edaneault/Livre-RPIZ/cad/infos-vis-ecrous.txt

trou 3 mm diam
écrou 4.8 encore semi tight, 1.56mm d'épais

Plexi : 1.7 mm
