edaneault/Livre-RPIZ/images/FOND2.BMP

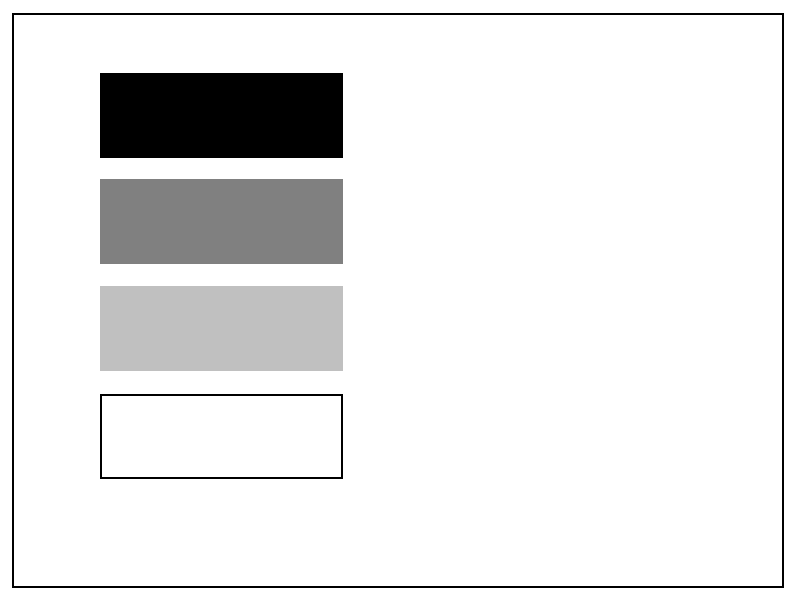
images/FOND2.BMP
