edaneault/Livre-RPIZ/images/FOND.BMP

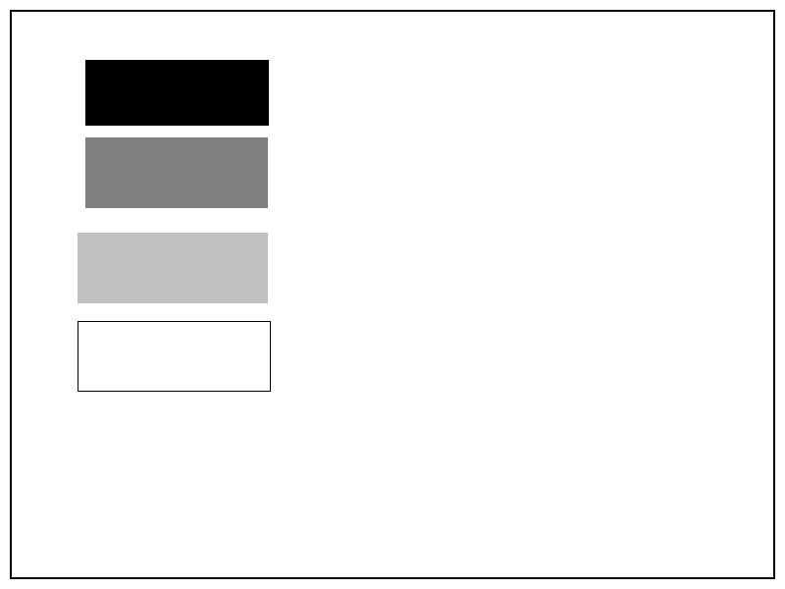
images/FOND.BMP
