edaneault/Livre-RPIZ/images/Maisonneuve.jpg

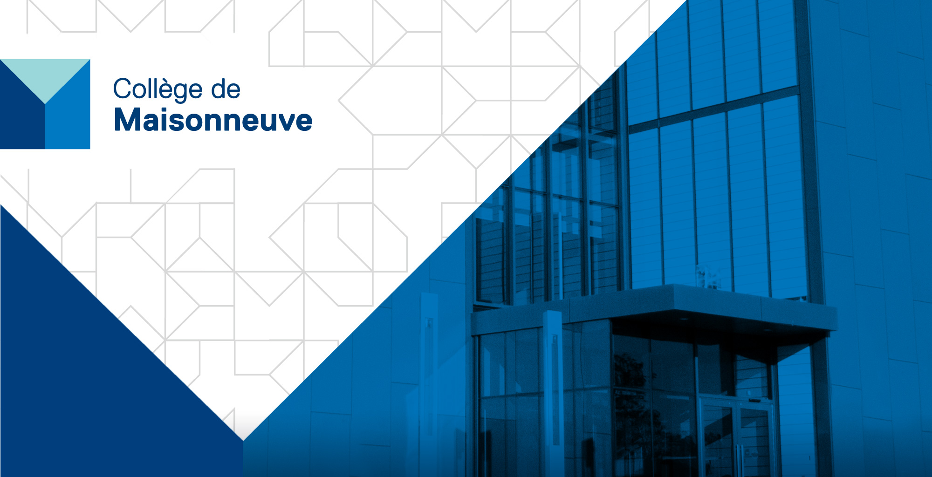
images/Maisonneuve.jpg
