edaneault/Livre-RPIZ/images/PIC4B.BMP

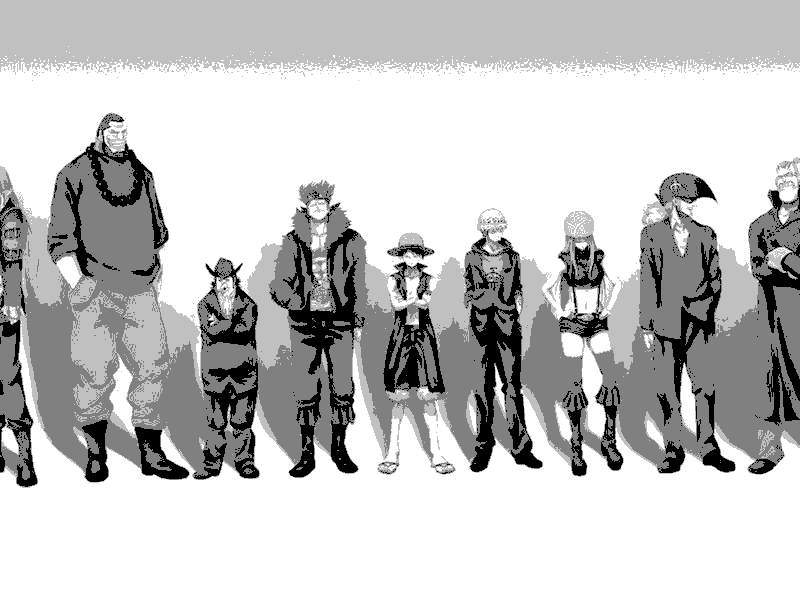
images/PIC4B.BMP
