edaneault/Livre-RPIZ/images/PIC22.BMP

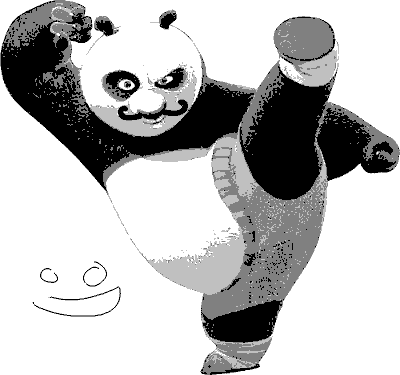
images/PIC22.BMP
