edaneault/Livre-RPIZ/images/selection/FIN23.BMP

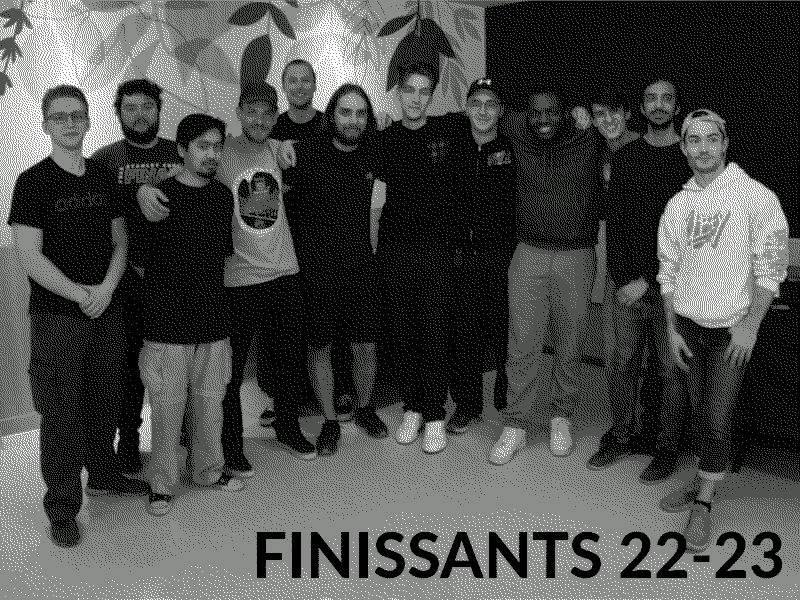
images/selection/FIN23.BMP
