edaneault/Livre-RPIZ/images/selection/KID.BMP

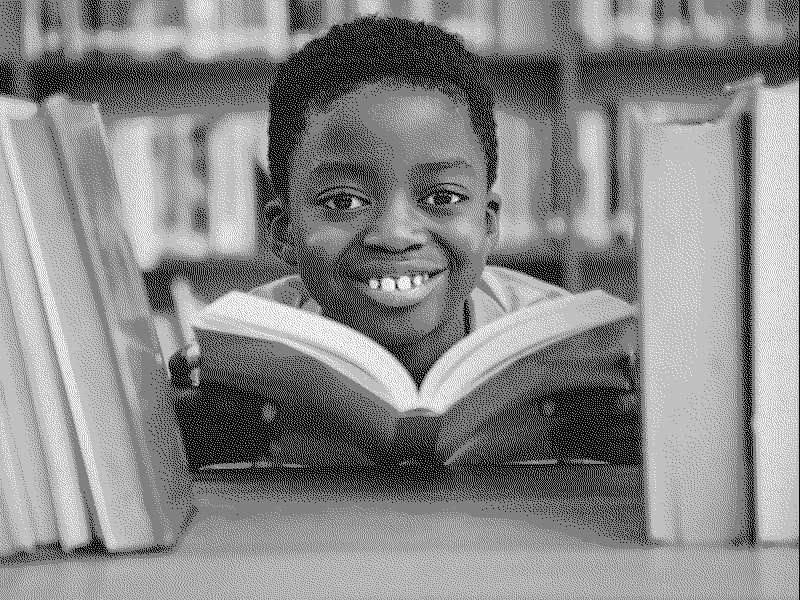
images/selection/KID.BMP
