edaneault/Livre-RPIZ/images/selection/L1984.BMP

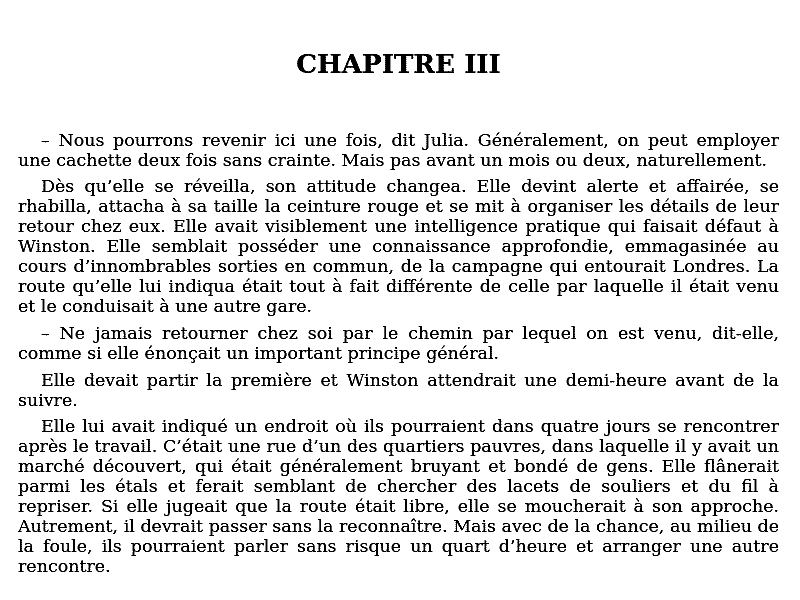
images/selection/L1984.BMP
