edaneault/Livre-RPIZ/images/selection/LABO.BMP

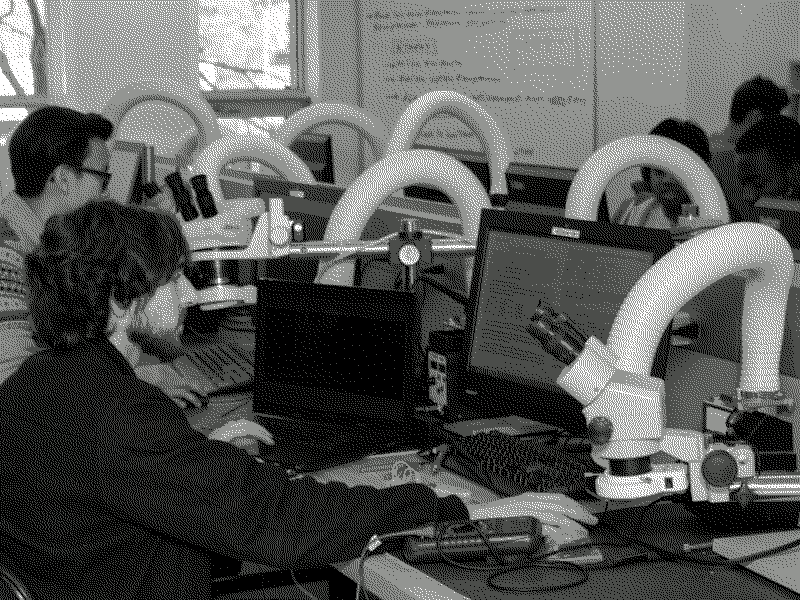
images/selection/LABO.BMP
