edaneault/Livre-RPIZ/images/selection/LIVRES.BMP

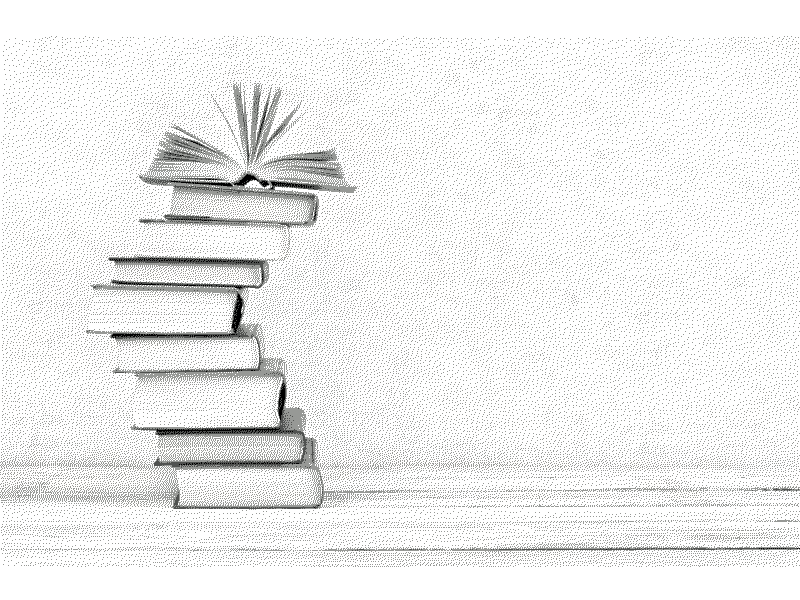
images/selection/LIVRES.BMP
