edaneault/Livre-RPIZ/images/selection/MAIS.BMP

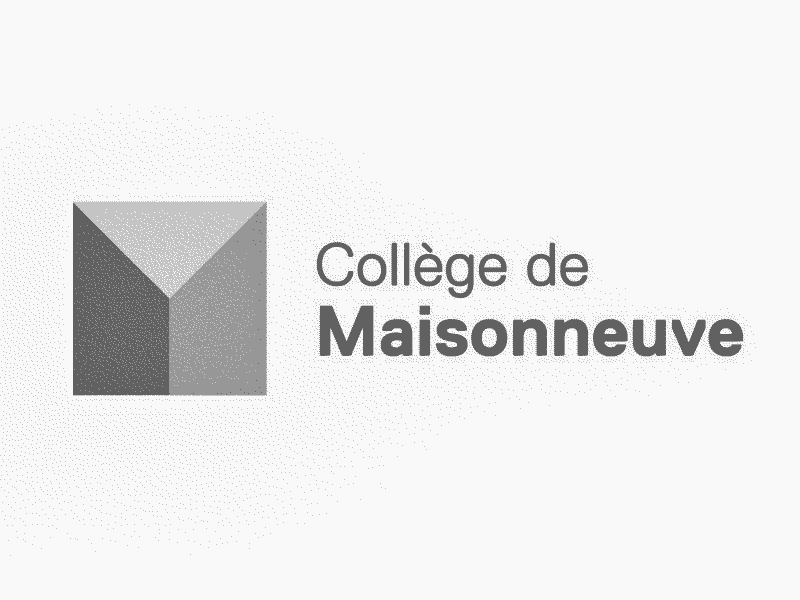
images/selection/MAIS.BMP
