edaneault/Livre-RPIZ/images/selection/MONTR.BMP

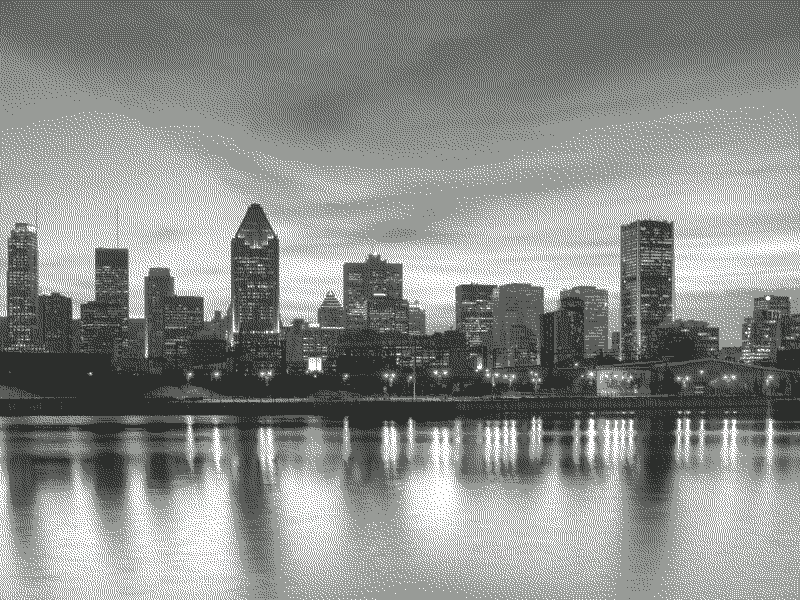
images/selection/MONTR.BMP
