edaneault/Livre-RPIZ/images/selection/TERRE.BMP

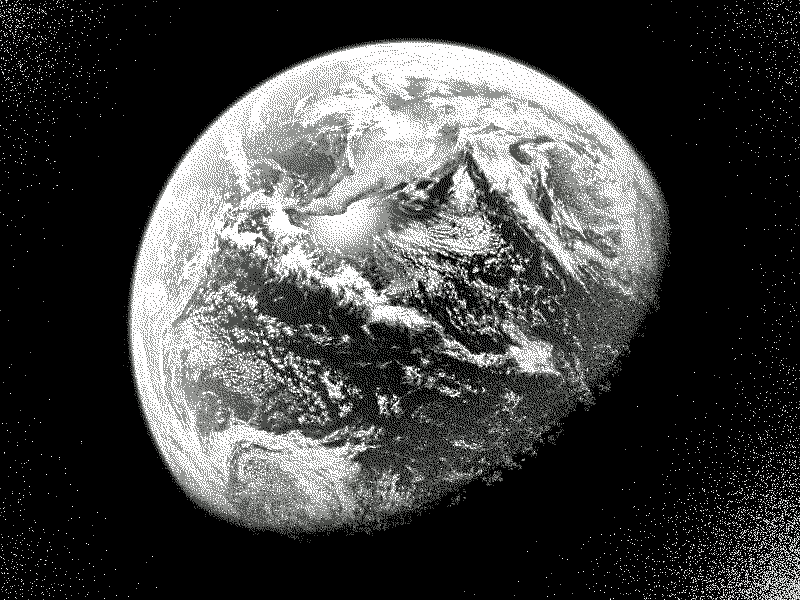
images/selection/TERRE.BMP
