edaneault/Livre-RPIZ/images/SOL.BMP

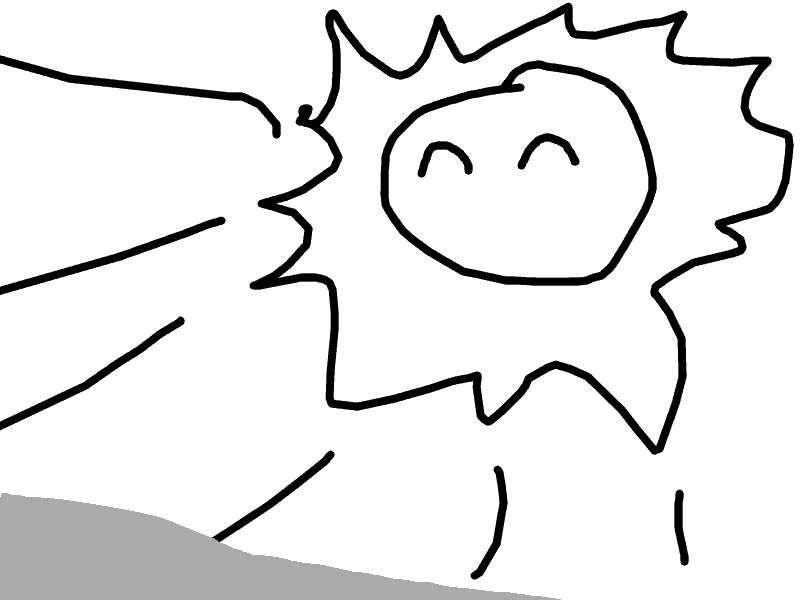
images/SOL.BMP
