edaneault/Livre-RPIZ/images/ZEN.BMP

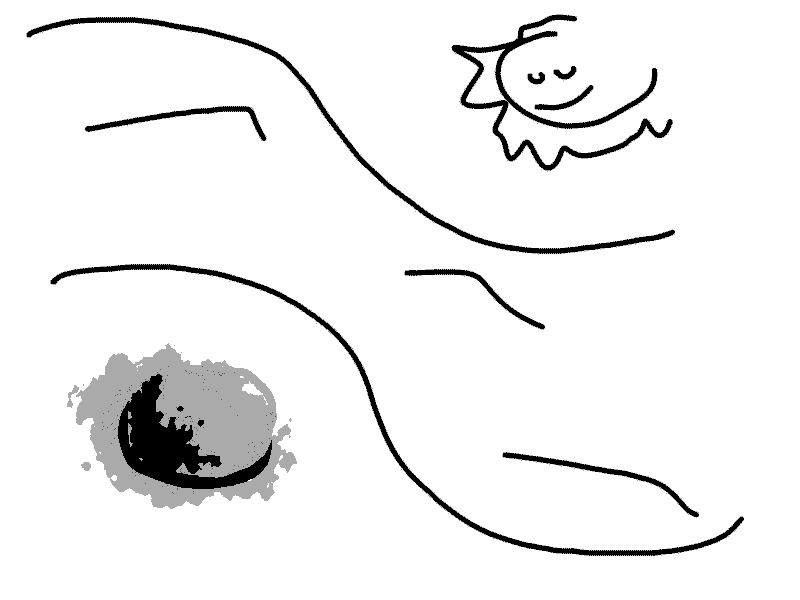
images/ZEN.BMP
