edaneault/Livre-RPIZ/circuit/BOM.ods

Sheet: Sheet1
 | Deux commandes : Digikey et Amazon. On vole L1 et U2 de commande amazon. Pour environ 55$ j’ai tous mes pièces, livrées en peu de temps, avec un peu d’extra.
 | https://www.amazon.ca/-/fr/Eiechip-MT3608-convertisseurs-tension-r%C3%A9gulateur/dp/B0C54TDQXC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
 | Attention de modifier footprint L1.
Item | Short description | Qty | Reference(s) | Value | MfgPartNo | Specifications | Commande | Digikey Part Number
1 | Capacitor, tantalum, 22uF | 4 | C1, C2, C3, C4 | 22uF | TAJB226K020RNJ | Min 4.7uF | Digikey | 478-1683-1-ND
2 | TVS diode | 1 | D1 | TVS | EGA10603V12B0DG |  | Digikey | 3526-EGA10603V12B0DGCT-ND
3 | Indication green LED | 1 | D2 | CHARGE | 150141GS73100 | Simple, indication, 5V tolerant. | Digikey | 732-4997-1-ND
4 | Shottky diode | 2 | D3, D4 | ~ | SS34 |  | Digikey – Ou j’en vole 1 de module? | 1801-SS34CT-ND
5 | Micro USB B connector | 1 | J1 | MICROB | 10118194-0001LF |  | Digikey | 609-4618-1-ND
6 | JST 2 pin TH connector | 1 | J2 | LIPO | S2B-PH-K-S | Compatible PHR-2 | Digikey | 455-1719-ND
7 | 20 x 2 0.1 connector | 1 | J3 | RPI | PPTC202LFBN-RC | 2x20_0.1pitch_header_female | Digikey | S6104-ND
8 | JST 6 pin SMD connector | 1 | J4 | EINK | S6B-XH-SM4-TB |  | Digikey | 455-2264-1-ND
9 | JST 6 pin mating connector housing | 2 |  |  | XHP-6 |  | Digikey | 455-2218-ND
10 | JST socket contact | 14 |  |  | SXH-002T-P0.6 | 6 per 6 pin connector, +2 test PHR-2 | Digikey | 455-2261-1-ND
11 | Inductor, 22uH | 1 | L1 | 22uH | TPMC 1004H-220MG-D |  | Transplanté de module Amazon | 4816-TMPC1004H-220MG-DCT-ND
12 | MOSFET, P-chan, enhan | 2 | Q1, Q2 | ~ | DMP2045U |  | Digikey | DMP2045U-7DICT-ND
13 | Resistor, 15k | 5 | R2, R3, R4, R9, R13 | 15k | RMCF1206FT15K0 |  | Digikey | RMCF1206FT15K0CT-ND
14 | Resistor, 2k | 5 | R5, R6, R7, R8, R14 | 2k | RMCF1206FG2K00 | 2k, precise (FB of DCDC) | Digikey | 738-RMCF1206FG2K00CT-ND
15 | Resistor, 6.2k | 3 | R10, R11, R12 | 6.2k | RMCF1206JT6K20 |  | Digikey | RMCF1206JT6K20CT-ND
16 | Trimmer, 100k | 1 | RV1 | 100k | TC33X-2-104E | 100k | Digikey | TC33X-104ECT-ND
17 | DPST switch | 1 | SW1 | PWR | SLW-108645-4A-RA-D | Double pole, single throw or double throw | Digikey | 2223-SLW-108645-4A-RA-D-ND
18 | Push-button | 3 | SW2, SW3, SW4 | Varied | PTS815 SJM 250 SMTR LFS | Button | Digikey | CKN12215-1-ND
19 | IC, LiPo charger | 1 | U1 | MCP73831/2 | MCP73831T-2ACI/OT |  | Digikey | MCP73831T-2ACI/OTCT-ND
20 | IC, DCDC boost converter | 1 | U2 | MT3608 | MT3608 |  | Transplanté de module Amazon | -
 | Ajout :
21 | PHR-2 (Pour tests batterie) | 1 |  |  | PHR-2
 | Remplacer :
7 | 20 x 2 0.1 connector |  |  |  | 61304021821 |  |  | 732-61304021821-ND

Sheet: Sheet2
TAJB226K020RNJ | 4
EGA10603V12B0DG | 1
150141GS73100 | 1
SS34 | 2
10118194-0001LF | 1
S2B-PH-K-S | 1
PPTC202LFBN-RC | 1
S6B-XH-SM4-TB | 1
XHP-6 | 2
SXH-002T-P0.6 | 12
TPMC 1004H-220MG-D | 1
DMP2045U | 2
RMCF1206FT15K0 | 5
RMCF1206FG2K00 | 5
RMCF1206JT6K20 | 3
TC33X-2-104E | 1
SLW-108645-4A-RA-D | 1
PTS815 SJM 250 SMTR LFS | 3
MCP73831T-2ACI/OT | 1
MT3608 | 1
