edaneault/Livre-RPIZ/circuit/procedure-montage-miseEnRoute.ods

 |  |  |  | Valeur mesurée attendue
Ligne | Type d’action | Action | Référence | Min | Typ | Max | Unité | Valeur mesurée | FAIT?
001 | Info | Section : Alimentations de base
002 | Assemblage | Assembler connecteur EINK | J4
003 | Assemblage | Assembler connecteur LIPO | J2
004 | Manipulation | Préparer connecteur JST PHR-2 vers pigtail
005 | Manipulation | Alimenter connecteur avec PSU à 4.2V
006 | Manipulation | Alimenter +BATT à 4.2V | J2
007 | Info | Par défaut, mesurer tensions par rapport à GND | TP2
008 | Mesure | Mesurer +BATT | TP5 |  | 4.2 |  | V
009 | Manipulation | Déconnecter et fermer alimentation +BATT | J2
010 | Assemblage | Assembler entrée Micro USB B | J1, D1
011 | Manipulation | Alimenter VBUS à 5V (de PSU USB externe) | J1
012 | Mesure | Mesurer VBUS | TP1 |  | 5.0 |  | V
013 | Manipulation | Déconnecter alimentation VBUS | J1
014
015 | Info | Section : Interrupteur et gestion Vin pour DC-DC
016 | Assemblage | Assembler entrée DC-DC | Q2, R9, D3, SW1
017 | Manipulation | Placer interrupteur PWR en position ouverte | SW1
018 | Manipulation | Alimenter +BATT à 4.2V | J2
019 | Mesure | Mesurer +BATT | TP5 |  | 4.2 |  | V
020 | Mesure | Mesurer DC-DC IN | TP6 |  | 0.0 |  | V
021 | Manipulation | Placer interrupteur PWR en position fermée | SW1
022 | Mesure | Mesurer +BATT | TP5 |  | 4.2 |  | V
023 | Mesure | Mesurer DC-DC IN | TP6 |  | 4.2 |  | V
024 | Manipulation | Déconnecter et fermer alimentation +BATT | J2
025 | Manipulation | Placer interrupteur PWR en position ouverte | SW1
026 | Manipulation | Alimenter VBUS à 5V | J1
027 | Mesure | Mesurer VBUS | TP5 |  | 5.0 |  | V
028 | Mesure | Mesurer DC-DC IN | TP6 |  | 0.0 |  | V
029 | Manipulation | Placer interrupteur PWR en position fermée | SW1
030 | Mesure | Mesurer VBUS | TP5 |  | 5.0 |  | V
031 | Mesure | Mesurer DC-DC IN | TP6 |  | 4.7 |  | V
032 | Manipulation | Alimenter +BATT à 4.2V | J2
033 | Mesure | Mesurer +BATT | TP5 |  | 4.2 |  | V
034 | Mesure | Mesurer VBUS | TP5 |  | 5.0 |  | V
035 | Mesure | Mesurer DC-DC IN | TP6 |  | 4.7 |  | V
036 | Manipulation | Déconnecter alimentation VBUS | J1
037 | Mesure | Mesurer DC-DC IN | TP6 |  | 4.2 |  | V
038 | Manipulation | Ré-alimenter VBUS à 5V | J1
039 | Mesure | Mesurer DC-DC IN | TP6 |  | 4.7 |  | V
040 | Manipulation | Déconnecter et fermer alimentations VBUS et +BATT | J1, J2
041
042 | Info | Section : DC-DC
043 | Assemblage | Assembler convertisseur DC-DC (I) | U2, C3, R14, R13
044 | Assemblage | Assembler convertisseur DC-DC (II) | C2, L1, D4
045 | Manipulation | Alimenter +BATT à 4.2V | J2
046 | Mesure | Mesurer +5V | TP16 |  | 5.1 |  | V
047 | Mesure balayée | Faire varier +BATT de 4.2 à 3V en mesurant +5V | TP16 |  | 5.1 |  | V
048 | Manipulation | Alimenter VBUS à 5V | J1
049 | Mesure | Mesurer +5V | TP16 |  | 5.1 |  | V
050 | Manipulation | Déconnecter et fermer alimentations VBUS et +BATT | J1, J2
051
052 | Info | Section : Charge LiPo
053 | Assemblage | Assembler chargeur LiPo (I) | U1, R8, R7, R6
054 | Assemblage | Assembler chargeur LiPo (II) | D2, C1
055 | Manipulation | Alimenter VBUS à 5V | J1
056 | Observation | Observer état DEL "CHARGE" | D2 | DEL éteinte
057 | Mesure | Mesurer +BATT | TP5 |  | 4.2
058 | Manipulation | Utiliser connecteur LIPO pour placer charge 10kΩ 2W entre +BATT et GND | J2
059 | Observation | Observer état DEL "CHARGE" | D2 | DEL allumée, verte
060 | Mesure | Mesurer +BATT | TP5 |  |  | 5.0 | V
061 | Mesure | Mesurer courant circulant dans connecteur | J2 |  |  | 500.0 | mA
062 | Manipulation | Déconnecter alimentations VBUS | J1
063 | Manipulation | Déconnecter charge sur connecteur LIPO | J2
064
065 | Info | Section : Suivi de la charge
066 | Assemblage | Assembler diviseur pour signal "CHARGING" | R2, R3
067 | Assemblage | Assembler détecteur batterie faible | Q1, RV1, R4
068 | Manipulation | Alimenter VBUS à 5V | J1
069 | Mesure | Mesurer MON_CHARGE | TP3 | 1.6 |  | 2.6 | V
070 | Manipulation | Utiliser connecteur LIPO pour placer charge 10kΩ 2W entre +BATT et GND | J2
071 | Mesure | Mesurer MON_CHARGE | TP3 | 0 |  | 0.9 | V
072 | Manipulation | Déconnecter charge sur connecteur LIPO | J2
073 | Manipulation | Ajuster potentiomètre RV1 à moitié de course (50%) | RV1
074 | Manipulation | Alimenter +BATT à 4.2V | J2
075 | Mesure | Mesurer MON_CHARGE | TP3 | 1.6 |  | 2.6 | V
076 | Info | Pour les deux prochaines mesures (ligne 78 et 80), ne pas arrêter si valeur
077 | Info | n’est pas proche de valeur typique. Arrêter si valeur > max seulement.
078 | Mesure | Mesurer MON_LOWBATT | TP4 |  | 0.0 | 3.3 | V
079 | Manipulation | Alimenter +BATT à 3.0V | J2
080 | Mesure | Mesurer MON_LOWBATT | TP4 |  | 3.3 | 3.3 | V
081 | Manipulation | Déconnecter et fermer alimentations VBUS et +BATT | J1, J2
082
083 | Info | Section : Boutons et interface RPI ↔ EINK
084 | Assemblage | Assembler boutons BACK, FWD et ACTION | SW4, SW3, SW2
085 | Assemblage | Assembler pull-ups associés | R11, R12, R10
086 | Assemblage | Assembler connecteur 2 x 20 RPI | J3
087 | Manipulation | Alimenter +3.3V sur J3 avec PSU externe (broche 1 +3.3V, broche 6 GND) | J3
088
089 | Info | Les lignes 90-100 sont de simples tests de bouton, détaillés par étapes
090 | Mesure | Mesurer GPIO24 | TP9 |  | 3.3 |  | V
091 | Mesure | Mesurer GPIO25 | TP13 |  | 3.3 |  | V
092 | Mesure | Mesurer GPIO27 | TP15 |  | 3.3 |  | V
093 | Manipulation | Appuyer et maintenir bouton BACK | SW2
094 | Mesure | Mesurer GPIO24 | TP9 |  | 0.0 |  | V
095 | Manipulation | Relacher bouton BACK, appuyer et maintenir bouton FWD | SW2, SW3
096 | Mesure | Mesurer GPIO25 | TP13 |  | 0.0 |  | V
097 | Manipulation | Relacher bouton FWD, appuyer et maintenir bouton ACTION | SW3, SW4
098 | Mesure | Mesurer GPIO27 | TP15 |  | 0.0 |  | V
099 | Manipulation | Relacher bouton ACTION | SW4
100 | Manipulation | Déconnecter et fermer alimentation +3.3V | J3
101
102 | Manipulation | Préparer sans activer une alimentation 4.2V sur +BATT | J2
103 | Mesure | Préparer capture one-shot à l’oscilloscope de +5V | Broche 2 J3
104 | Manipulation | Lancer capture en activant alimentation sur +BATT
105 | Mesure | Noter la présence et valeur maximum de pics de tension sur +5V | Broche 2 J3 |  |  | 5.25 | V
106
107
108
109
110
111
112
113
114
115
116
117
118
119
120
121
122
123
124
125
126
127
128
129
130
131
132
133
134
135
136
137
138
139
140
141
142
143
144
145
146
147
148
149
150
151
152
153
154
155
156
157
158
159
160
161
162
163
164
165
166
167
168
169
170
171
172
173
174
175
176
177
178
179
180
181
182
183
184
185
186
187
188
189
190
191
192
193
194
195
196
197
198
199
200
