edaneault/Livre-RPIZ/cad/assembly-explosion.FCStd

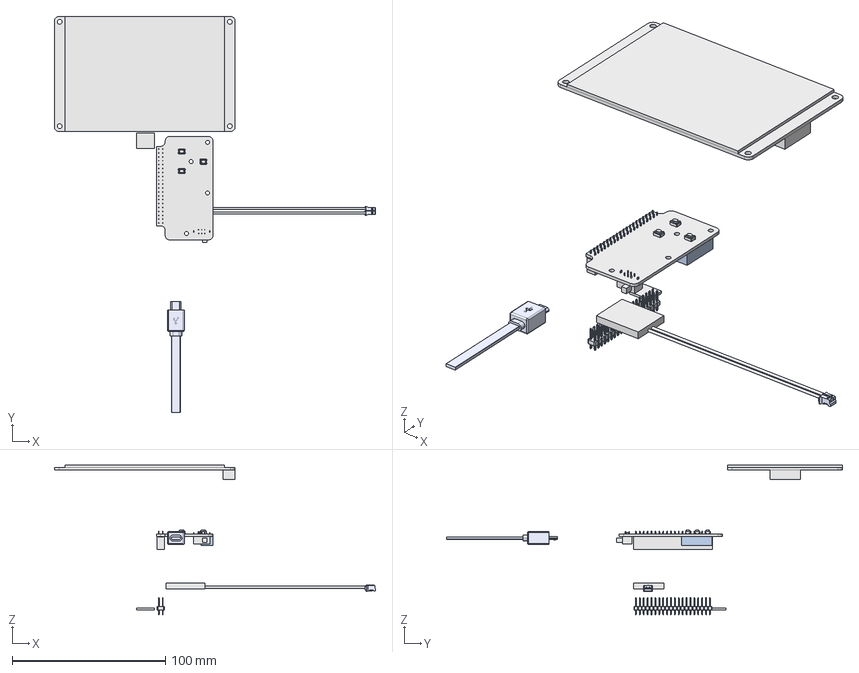
[picture p16: CAD file, 2024-03-27]
cad/assembly-explosion.FCStd
209.6 x 258.3 x 97.6 mm
Eink
SD
header_20x2_vert_t-h
PCB
PPTC202LFBN-RC001
MICRO USB CONNECTOR AND FLAT CABLE
JST-6pos
PTS815SJK251-BTN1
PTS815SJK251-BTN2
PTS815SJK251-BTN3
SlideSwitchSLW-108645
LiPo150mAh
PHR-2
