edaneault/Livre-RPIZ/cad/logos/logos.FCStd

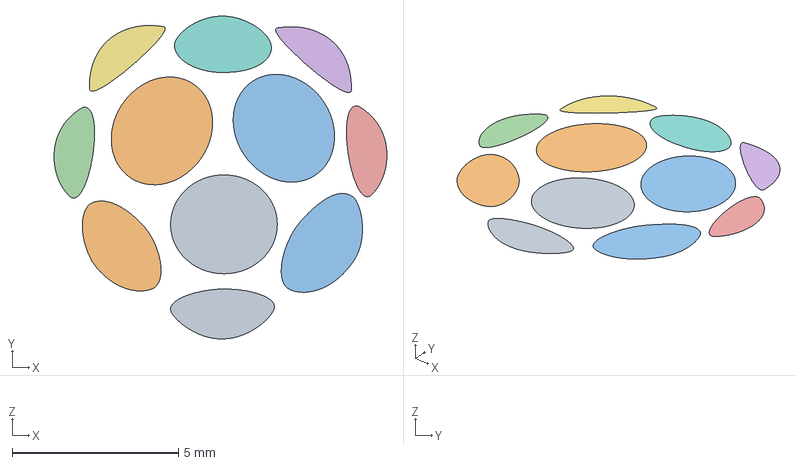
[picture p17: CAD file, 2024-03-27]
cad/logos/logos.FCStd
10.0 x 9.72 x 0 mm
path10730_0
path10732_6
path10734_1
path10736_5
path10738_5
path10740_4
path10742_7
path10744_6
path10746_5
path10748_6
path10750_9
