edaneault/Livre-RPIZ/cad/mesh/Bouton1.stl

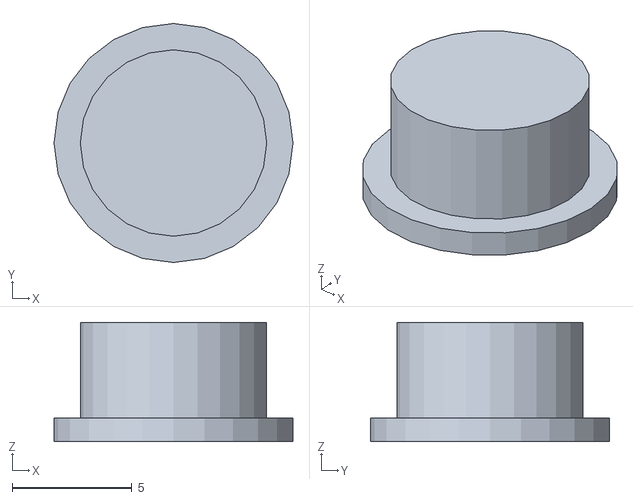
[picture p18: CAD file, 2024-03-27]
cad/mesh/Bouton1.stl
10.0 x 10.0 x 5.00
