edaneault/Livre-RPIZ/cad/RPI0W/RaspberryPiZeroW.STEP

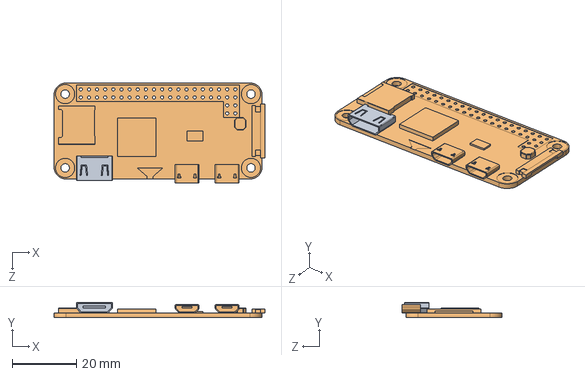
[picture p19: CAD file, 2024-03-27]
cad/RPI0W/RaspberryPiZeroW.STEP
65.9 x 4.80 x 31.2 mm
