edaneault/Livre-RPIZ/cad/mesh/Boitier.stl

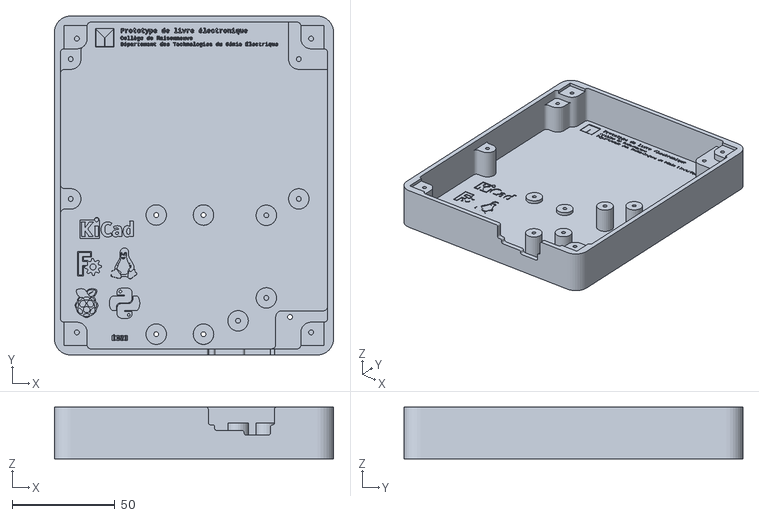
[picture p20: CAD file, 2024-03-27]
cad/mesh/Boitier.stl
136.0 x 165.0 x 25.2
