edaneault/Livre-RPIZ/cad/MICRO USB CONNECTOR AND FLAT CABLE.STEP

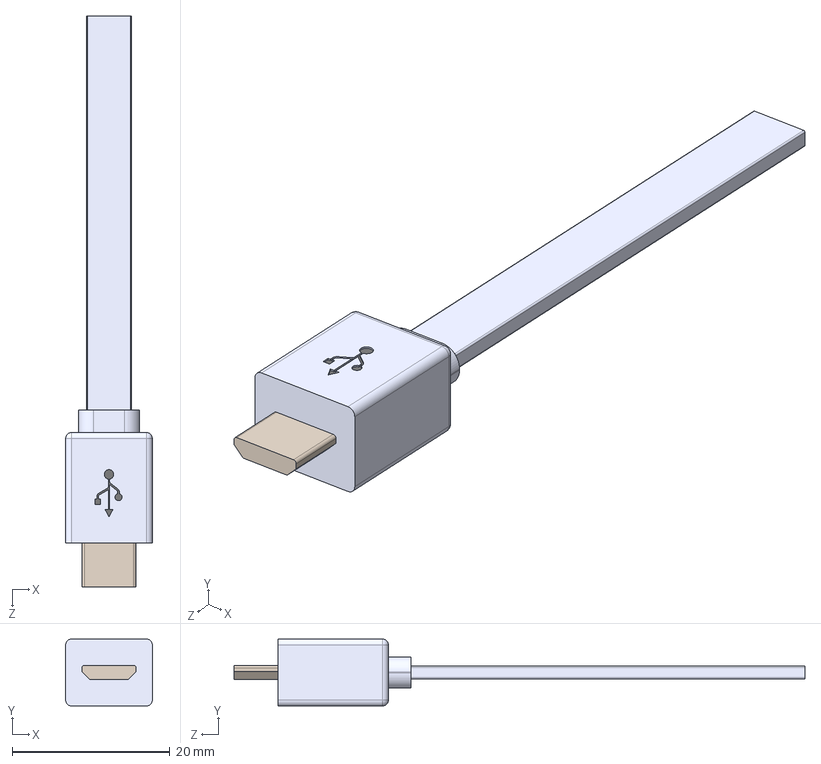
[picture p21: CAD file, 2024-03-27]
cad/MICRO USB CONNECTOR AND FLAT CABLE.STEP
11.0 x 8.50 x 72.5 mm
