edaneault/Livre-RPIZ/cad/li-poly-batt.FCStd

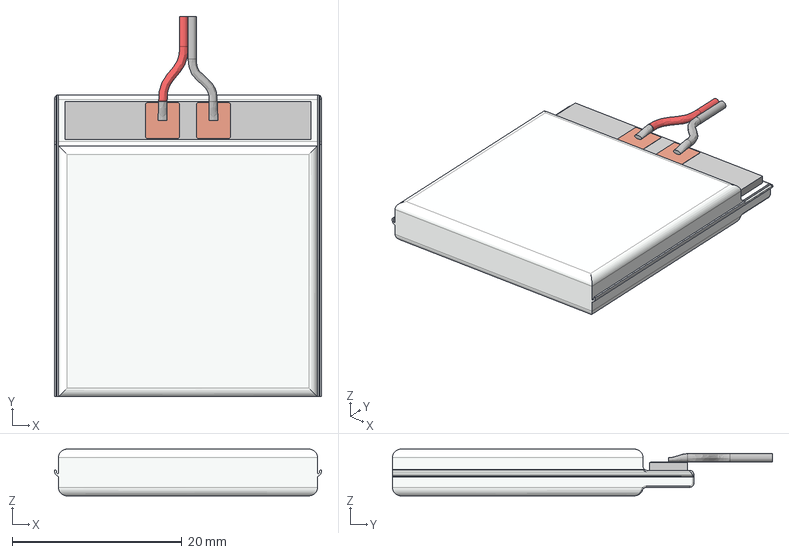
[picture p22: CAD file, 2024-03-27]
cad/li-poly-batt.FCStd
31.4 x 44.8 x 5.50 mm
