edaneault/Livre-RPIZ/cad/mesh/PorteBatterie.stl

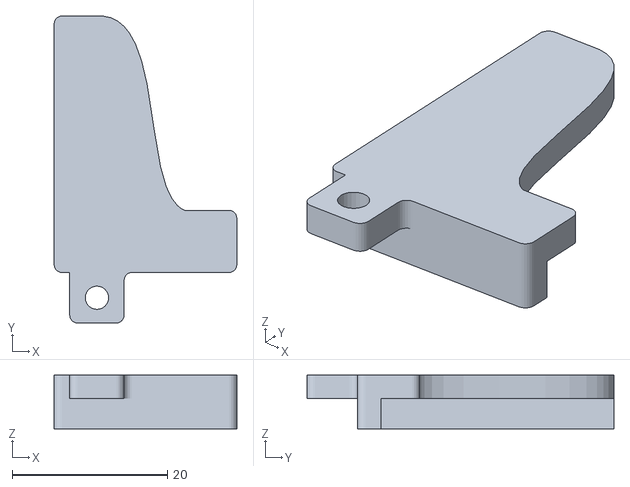
[picture p23: CAD file, 2024-03-27]
cad/mesh/PorteBatterie.stl
23.5 x 39.5 x 6.90
