edaneault/Livre-RPIZ/cad/plaque_trous.FCStd

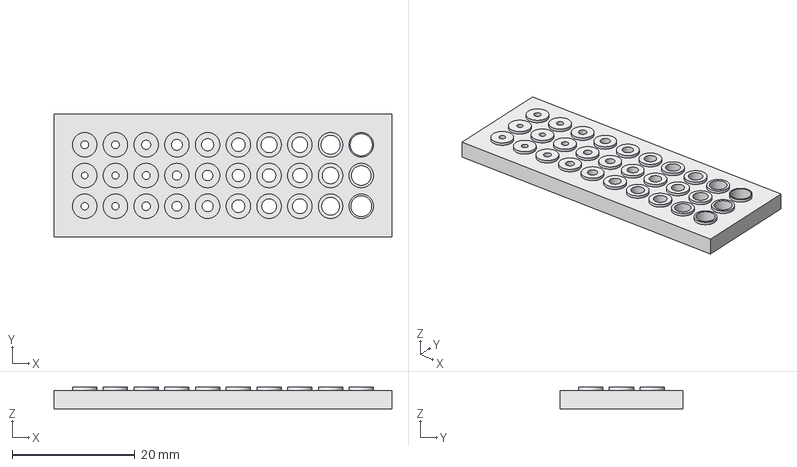
[picture p24: CAD file, 2024-03-27]
cad/plaque_trous.FCStd
55.0 x 20.0 x 3.50 mm
