edaneault/Livre-RPIZ/cad/mesh/base-fourche.stl

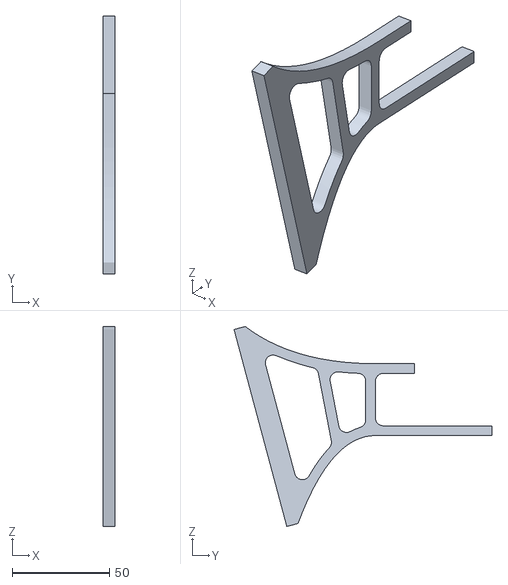
[picture p25: CAD file, 2024-03-27]
cad/mesh/base-fourche.stl
6.00 x 132.8 x 103.0
