edaneault/Livre-RPIZ/cad/PHR-2.step

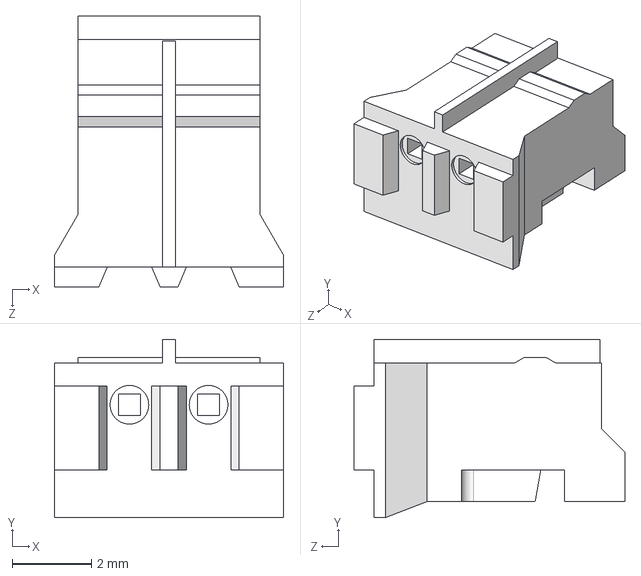
[picture p26: CAD file, 2024-03-27]
cad/PHR-2.step
5.80 x 4.50 x 6.85 mm
