edaneault/Livre-RPIZ/cad/circuit-V4.step

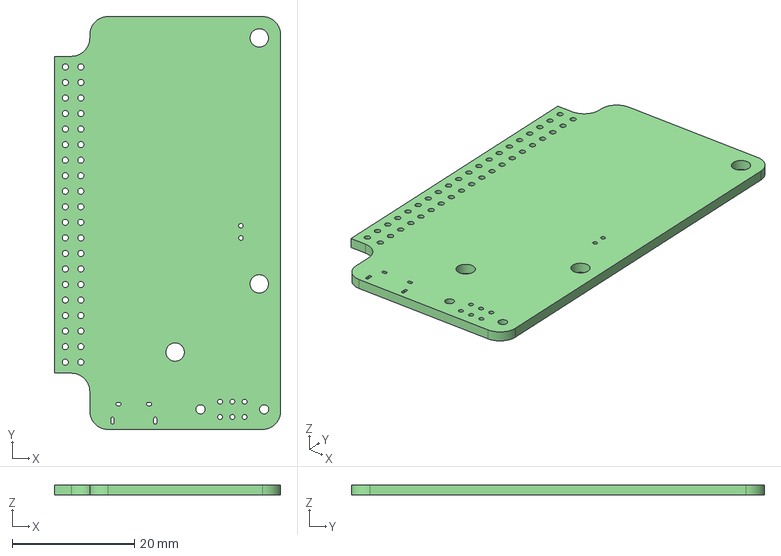
[picture p27: CAD file, 2024-03-27]
cad/circuit-V4.step
37.0 x 67.5 x 1.60 mm
