edaneault/Livre-RPIZ/cad/mesh/Boitier-V2.3mf

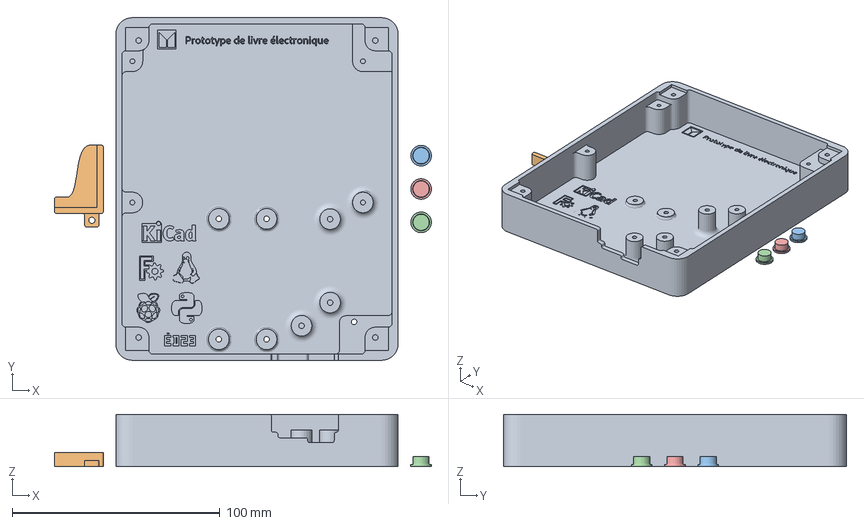
[picture p28: CAD file, 2024-03-27]
cad/mesh/Boitier-V2.3mf
181.5 x 165.0 x 25.2 mm
Boitier-V2.stl
PorteBatterie-V2.stl
Bouton1-V2.stl x 3
