edaneault/Livre-RPIZ/cad/slide-switch.FCStd

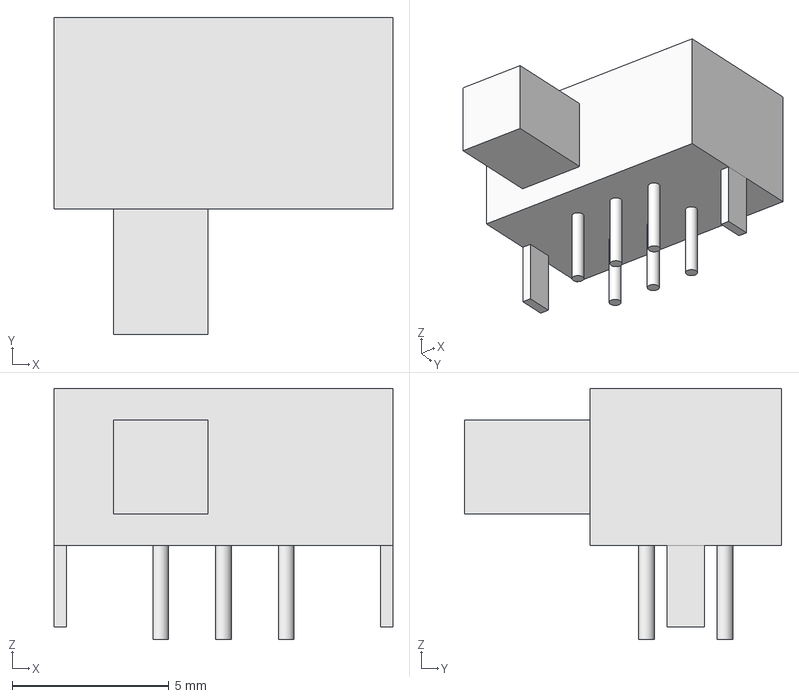
[picture p29: CAD file, 2024-03-27]
cad/slide-switch.FCStd
10.8 x 10.1 x 8.00 mm
