edaneault/Livre-RPIZ/cad/PPTC202LFBN-RC.step

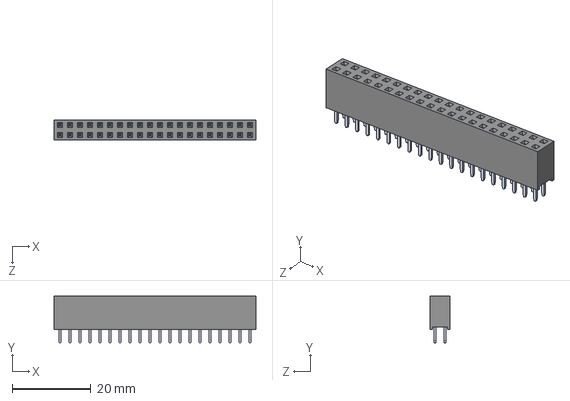
[picture p30: CAD file, 2024-03-27]
cad/PPTC202LFBN-RC.step
51.3 x 11.9 x 5.08 mm
2 row tin body_20
2 row tin pins x 20
