edaneault/Livre-RPIZ/cad/B2B-PH-K-S_LF__SN_.step

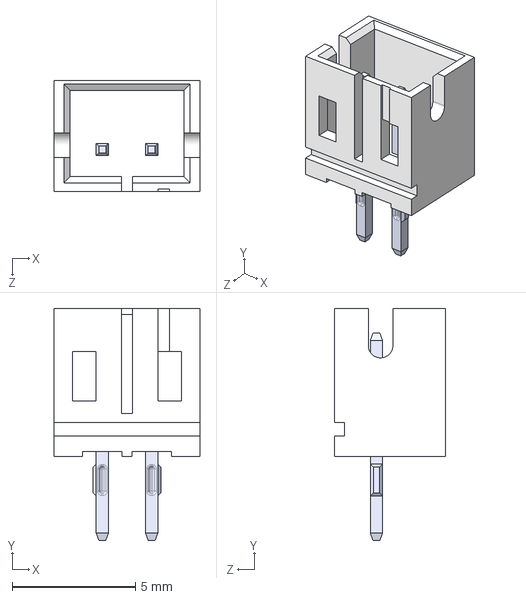
[picture p31: CAD file, 2024-03-27]
cad/B2B-PH-K-S_LF__SN_.step
5.90 x 9.40 x 4.50 mm
