edaneault/Livre-RPIZ/cad/mesh/base-base.stl

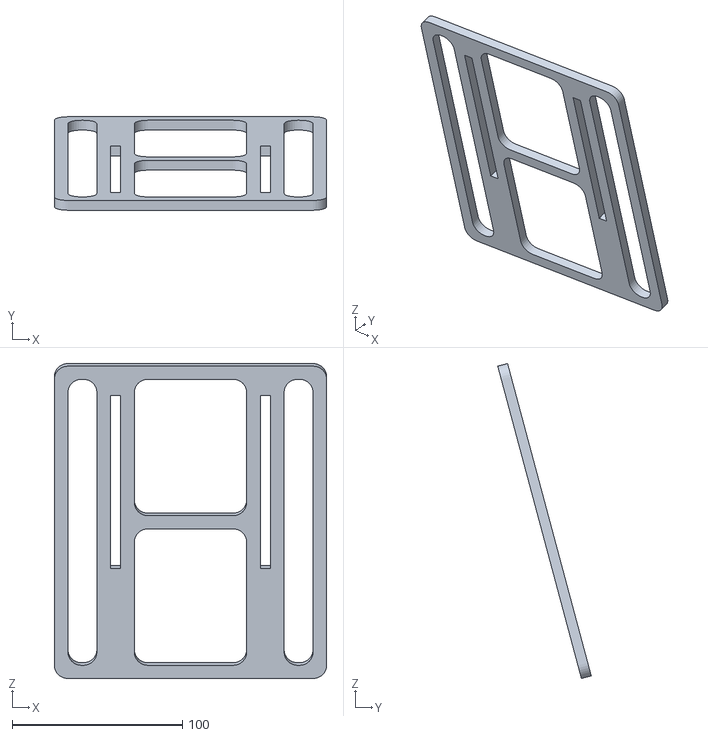
[picture p32: CAD file, 2024-03-27]
cad/mesh/base-base.stl
160.0 x 55.0 x 185.1
