edaneault/Livre-RPIZ/cad/header2x20.FCStd

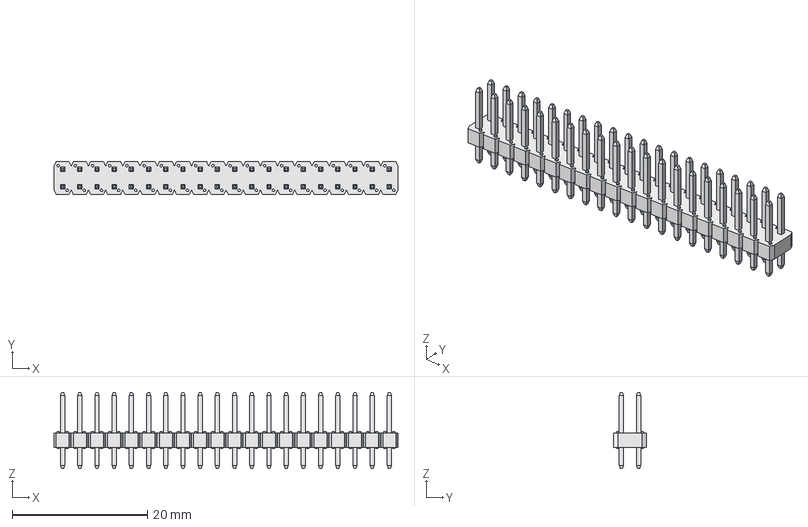
[picture p33: CAD file, 2024-03-27]
cad/header2x20.FCStd
50.8 x 4.82 x 11.2 mm
