edaneault/Livre-RPIZ/cad/PTS815SJK250.stp

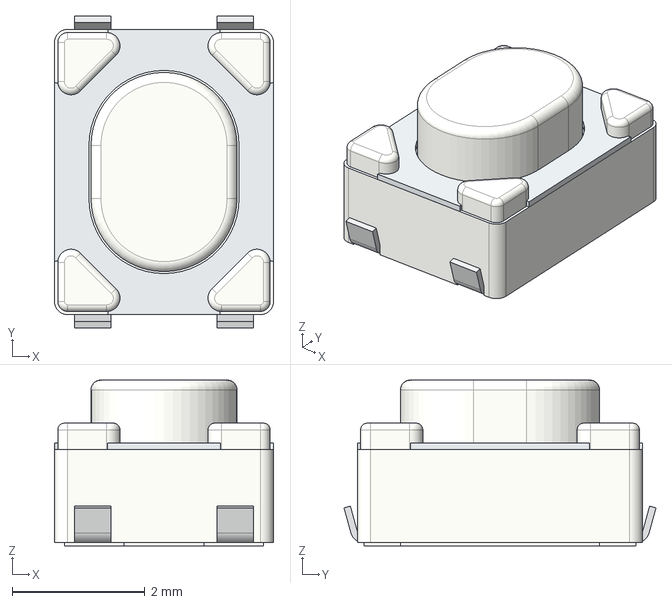
[picture p34: CAD file, 2024-03-27]
cad/PTS815SJK250.stp
3.30 x 4.70 x 2.50 mm
