edaneault/Livre-RPIZ/cad/pcb-dimensions.FCStd

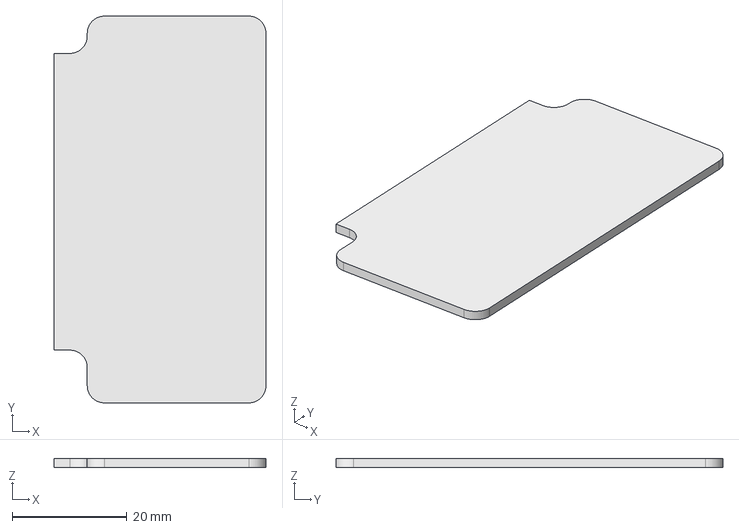
[picture p35: CAD file, 2024-03-27]
cad/pcb-dimensions.FCStd
37.0 x 67.5 x 1.60 mm
