edaneault/Livre-RPIZ/cad/S2B-PH-K-S_LF__SN_.step

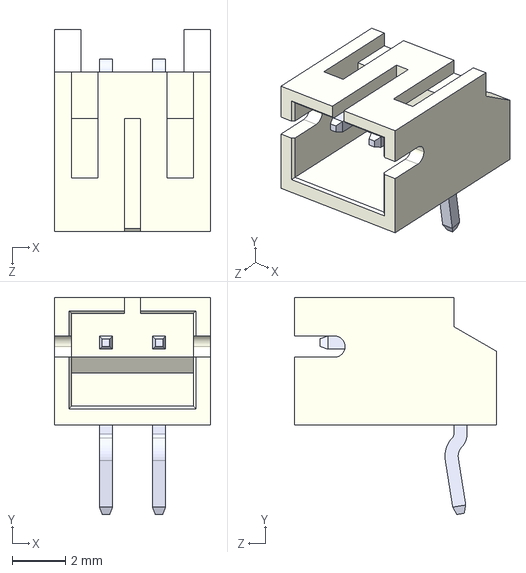
[picture p36: CAD file, 2024-03-27]
cad/S2B-PH-K-S_LF__SN_.step
5.90 x 8.18 x 7.60 mm
