edaneault/Livre-RPIZ/(list of files, cad)

Other CAD files:
cad/mesh/Bouton1-V2.stl
cad/mesh/plaqueTrous.stl
cad/10118194-0001LF.step
cad/RPI0W/RaspberryPiZeroW.STL
cad/mesh/Boitier-V2.stl
