edaneault/Livre-RPIZ/circuit/pcb-back.pdf

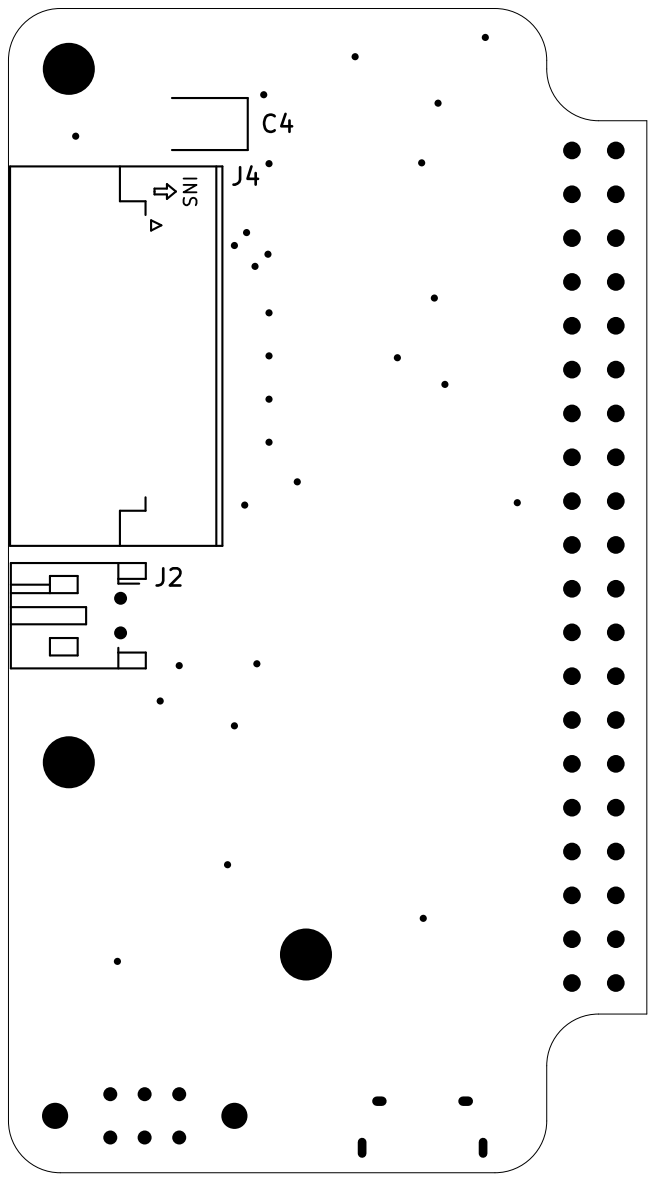
[picture p37: page 1]
