edaneault/Livre-RPIZ/circuit/pcb-front.pdf

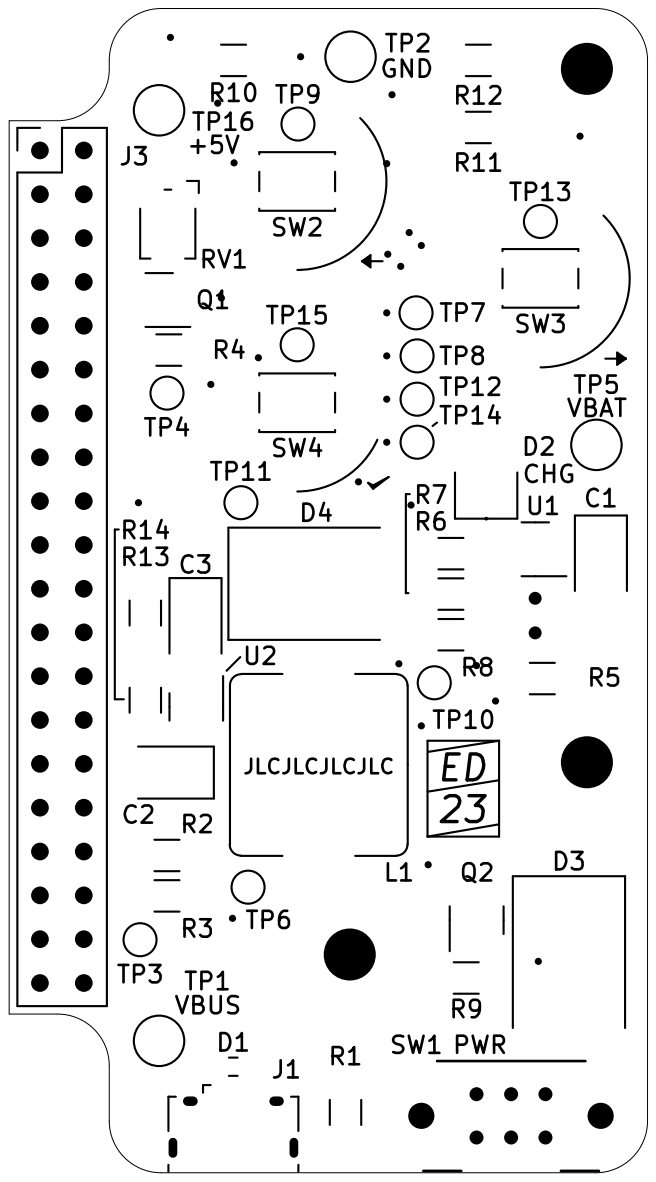
[picture p38: page 1]
