edaneault/Livre-RPIZ/circuit/circuit-V4.kicad_pcb

## KiCad design circuit/circuit-V4.kicad_pcb (2024-03-27)

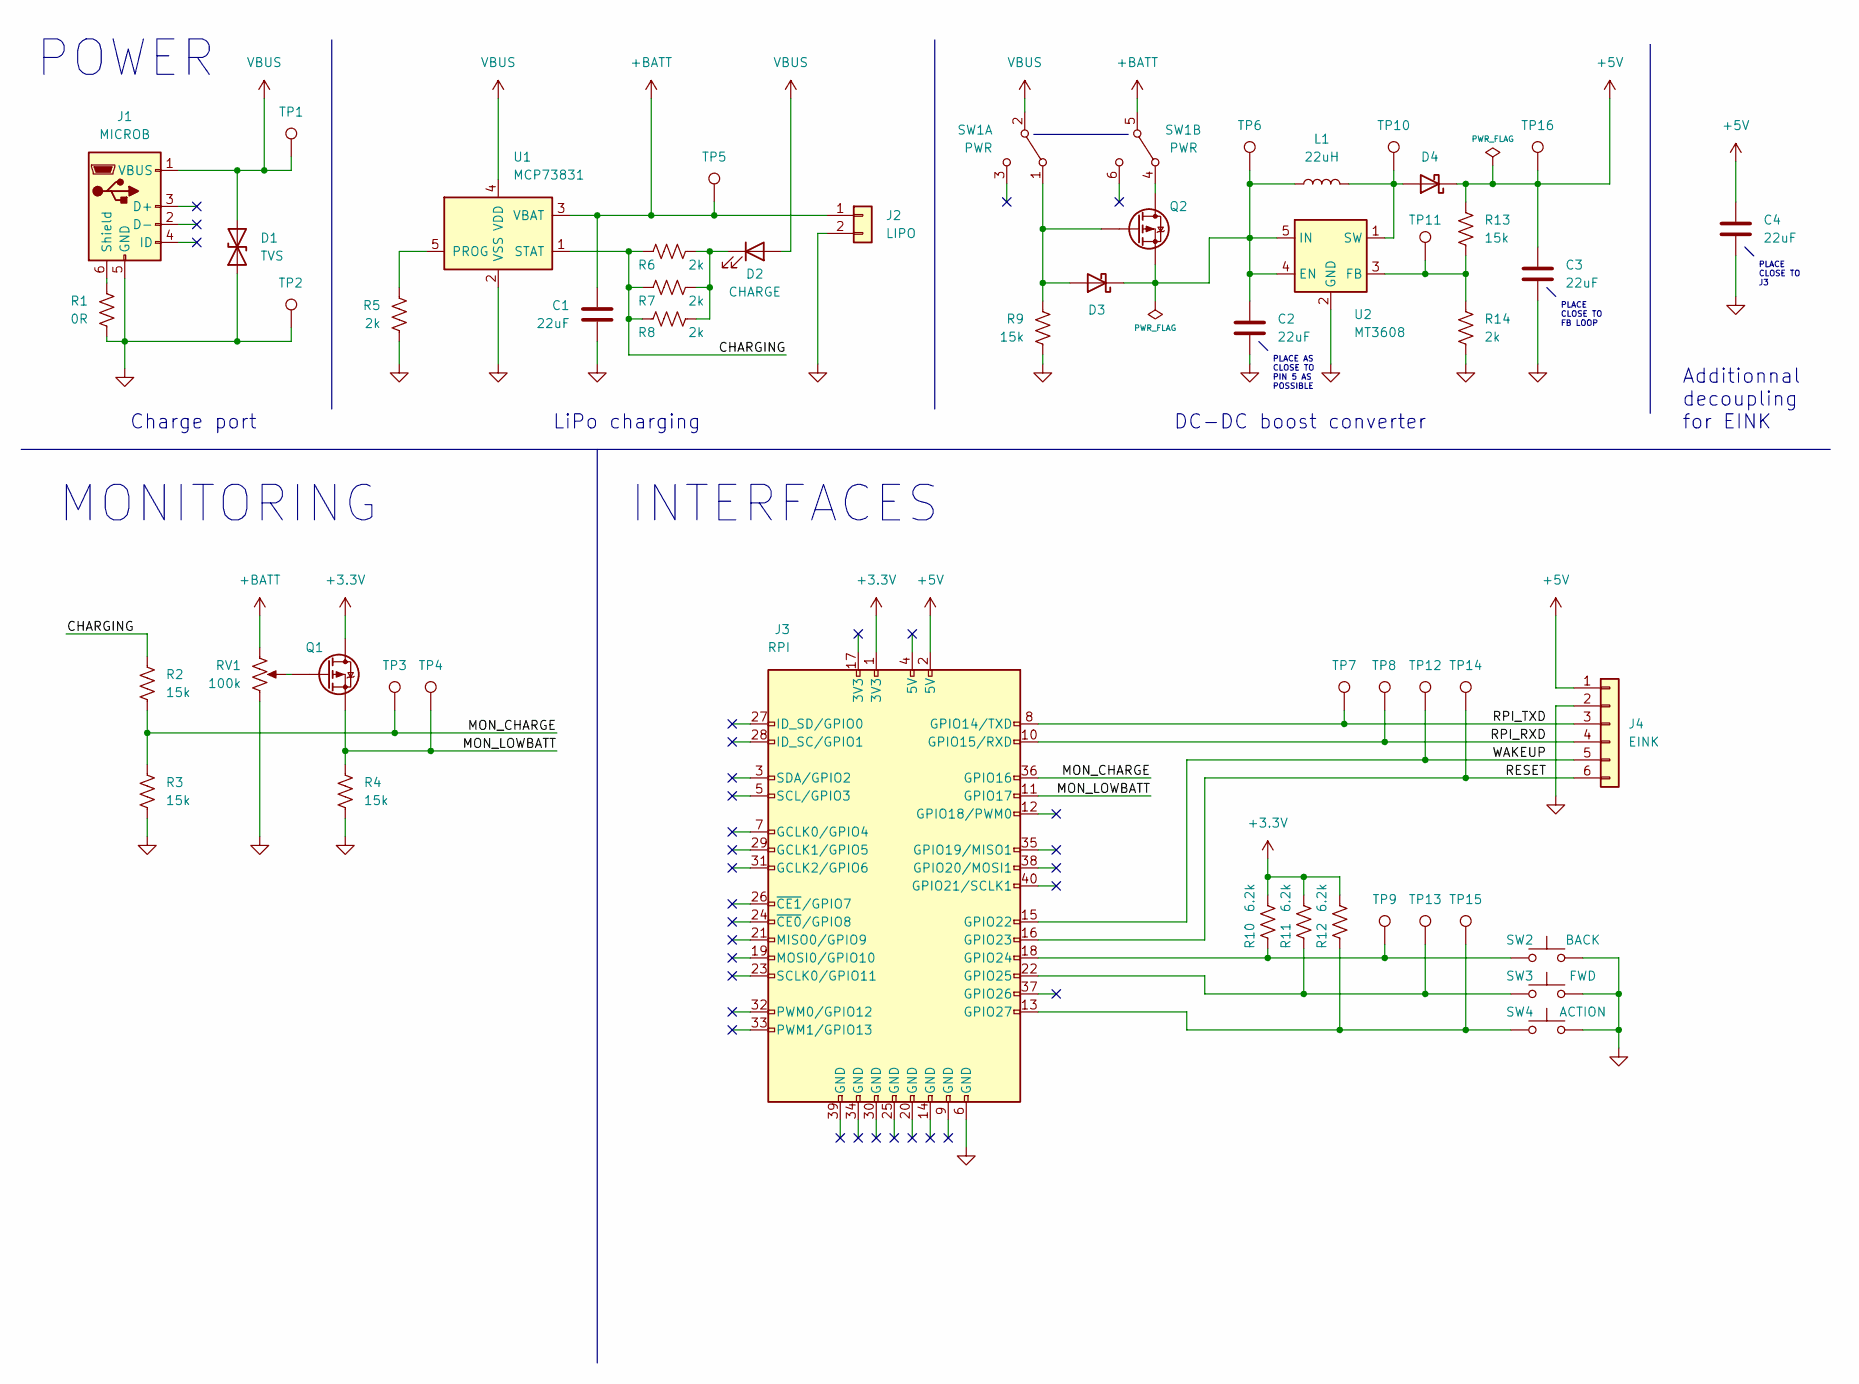
[picture p39: schematic circuit-V4.kicad_sch, LISEUSE ENCRE ELECTRONIQUE]

Parts:
C1, C2, C3, C4: 22uF; CP_EIA-3528-21_Kemet-B_Pad1.50x2.35mm_HandSolder; MfgPartNo TAJB226K020RNJ
D1: TVS; R_0603_1608Metric_Pad0.98x0.95mm_HandSolder; MfgPartNo EGA10603V12B0DG
D2: CHARGE; D_WURTH_3538; MfgPartNo 150141GS73100
D3, D4: D_SMC_FAIRCHILD; MfgPartNo SS34
J1: MICROB; USB_Micro-B_Amphenol_10118194_Horizontal; MfgPartNo 10118194-0001LF
J2: LIPO; JST_PH_S2B-PH-K_1x02_P2.00mm_Horizontal; MfgPartNo S2B-PH-K-S
J3: RPI; PinHeader_2x20_P2.54mm_Vertical; MfgPartNo PPTC202LFBN-RC
J4: EINK; JST_XH_S6B-XH-SM4-TB; MfgPartNo S6B-XH-SM4-TB
L1: 22uH; L_TaiTech_TMPC1004; MfgPartNo TPMC 1004H-220MG-D
Q1, Q2: SOT23_DIODESINC; MfgPartNo DMP2045U
R1: 0R; R_1206_3216Metric_Pad1.30x1.75mm_HandSolder; MfgPartNo NONE
R2, R3, R4, R9, R13: 15k; R_1206_3216Metric_Pad1.30x1.75mm_HandSolder; MfgPartNo RMCF1206FT15K0
R5, R6, R7, R8, R14: 2k; R_1206_3216Metric_Pad1.30x1.75mm_HandSolder; MfgPartNo RMCF1206FG2K00
R10, R11, R12: 6.2k; R_1206_3216Metric_Pad1.30x1.75mm_HandSolder; MfgPartNo RMCF1206JT6K20
RV1: 100k; Potentiometer_Bourns_TC33X_Vertical; MfgPartNo TC33X-2-104E
SW1: PWR; SLW-108645; MfgPartNo SLW-108645-4A-RA-D
SW2: BACK; SW_SPST_PTS815; MfgPartNo PTS815 SJM 250 SMTR LFS
SW3: FWD; SW_SPST_PTS815; MfgPartNo PTS815 SJM 250 SMTR LFS
SW4: ACTION; SW_SPST_PTS815; MfgPartNo PTS815 SJM 250 SMTR LFS
TP1, TP2, TP5, TP16: TestPoint_Pad_D2.5mm; MfgPartNo NONE
TP3, TP4, TP6, TP7, TP8, TP9, TP10, TP11, TP12, TP13, TP14, TP15: TestPoint_Pad_D1.5mm; MfgPartNo NONE
U1: MCP73831; SOT-23-5; MfgPartNo MCP73831T-2ACI/OT
U2: MT3608; SOT-23-6; MfgPartNo MT3608

Connections:
+3.3V: J3.1 (3V3), Q1.1 (D), R10.1, R11.1, R12.1
+5V: C3.1, C4.1, D4.1 (K), J3.2 (5V), J4.1, R13.1, TP16.1
+BATT: C1.1, J2.1, RV1.1, SW1.5 (B), TP5.1, U1.3 (VBAT)
/CHARGING: R2.1, R6.2, R7.2, R8.2, U1.1 (STAT)
/MON_CHARGE: J3.36 (GPIO16), R2.2, R3.1, TP3.1
/MON_LOWBATT: J3.11 (GPIO17), Q1.3 (S), R4.1, TP4.1
/RESET: J3.16 (GPIO23), J4.6, TP14.1
/RPI_RXD: J3.10 (GPIO15/RXD), J4.4, TP8.1
/RPI_TXD: J3.8 (GPIO14/TXD), J4.3, TP7.1
/WAKEUP: J3.15 (GPIO22), J4.5, TP12.1
GND: C1.2, C2.2, C3.2, C4.2, D1.1 (A1), J1.5 (GND), J2.2, J3.6 (GND), J4.2, R1.2, R3.2, R4.2, R5.2, R9.2, R14.2, RV1.3, SW2.2, SW3.2, SW4.2, TP2.1, U1.2 (VSS), U2.2 (GND)
unnamed: C2.1, D3.1 (K), L1.1, Q2.3 (S), TP6.1, U2.4 (EN), U2.5 (IN)
unnamed: D2.1 (K), R6.1, R7.1, R8.1
unnamed: D3.2 (A), Q2.2 (G), R9.1, SW1.1 (A)
unnamed: D4.2 (A), L1.2, TP10.1, U2.1 (SW)
unnamed: J1.6 (Shield), R1.1
unnamed: J3.13 (GPIO27), R12.2, SW4.1, TP15.1
unnamed: J3.18 (GPIO24), R10.2, SW2.1, TP9.1
unnamed: J3.22 (GPIO25), R11.2, SW3.1, TP13.1
unnamed: Q1.2 (G), RV1.2
unnamed: Q2.1 (D), SW1.4 (A)
unnamed: R5.1, U1.5 (PROG)
unnamed: R13.2, R14.1, TP11.1, U2.3 (FB)
VBUS: D1.2 (A2), D2.2 (A), J1.1 (VBUS), SW1.2 (B), TP1.1, U1.4 (VDD)

Notes on the sheet:
PLACE AS CLOSE TO PIN 5 AS POSSIBLE
INTERFACES
DC-DC boost converter
MONITORING
POWER
LiPo charging
PLACE CLOSE TO J3
Additionnal decoupling for EINK
Charge port
PLACE CLOSE TO FB LOOP

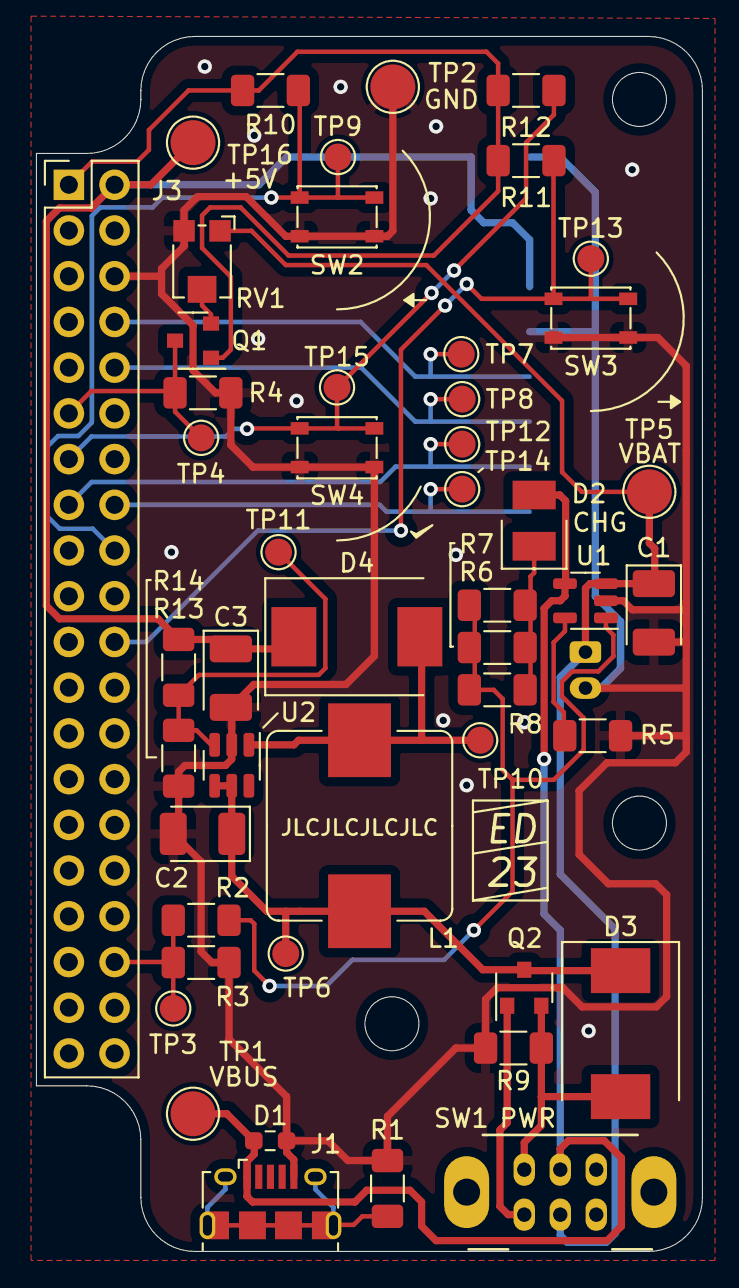
[picture p40: board circuit-V4.kicad_pcb from above]

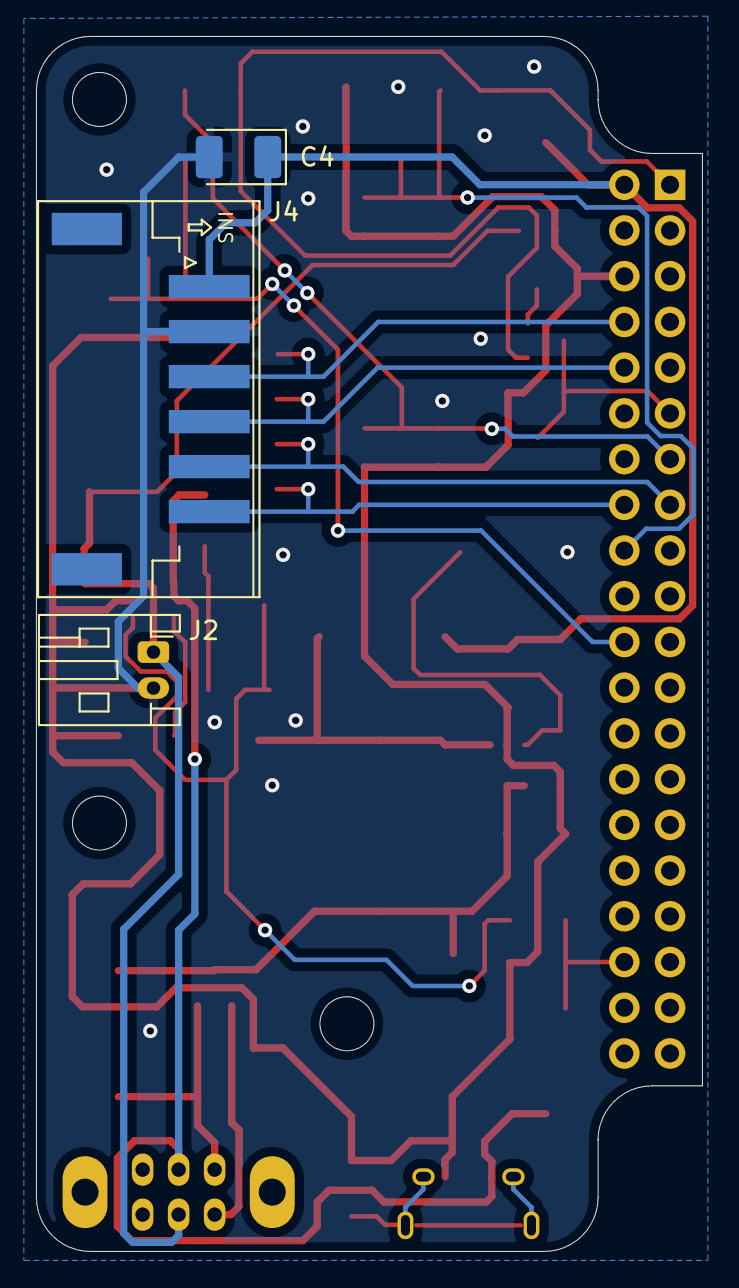
[picture p41: board circuit-V4.kicad_pcb from below]

Board: 2 copper layers, 37.0 x 67.5 mm, 52 parts (3 on the bottom side), 24 nets.
